timmit99/TRA_KiCad_Library/README.md

# TRA_KiCad_Library
Library of my KiCad Parts
