timmit99/TRA_KiCad_Library/3D Models/Amphenol/ssfv24r_4stlf.stp

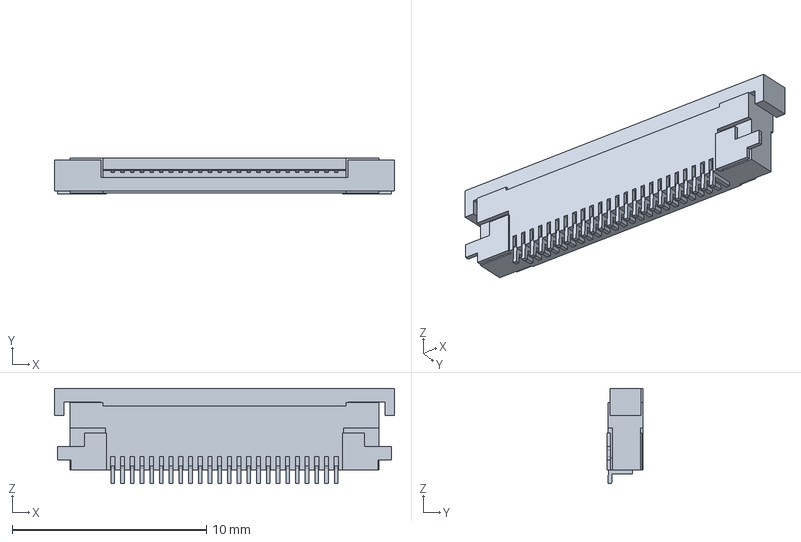
[picture p1: CAD file, 2019-06-06]
3D Models/Amphenol/ssfv24r_4stlf.stp
17.5 x 1.87 x 4.90 mm
