timmit99/TRA_KiCad_Library/3D Models/CUI Devices/SDS-60J.step

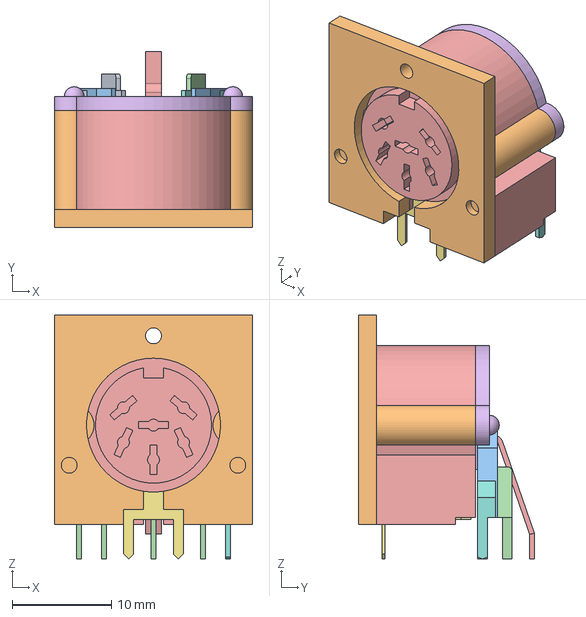
[picture p2: CAD file, 2020-04-30]
3D Models/CUI Devices/SDS-60J.step
20.0 x 17.8 x 24.6 mm
