timmit99/TRA_KiCad_Library/3D Models/en11-hsm1af15.STEP

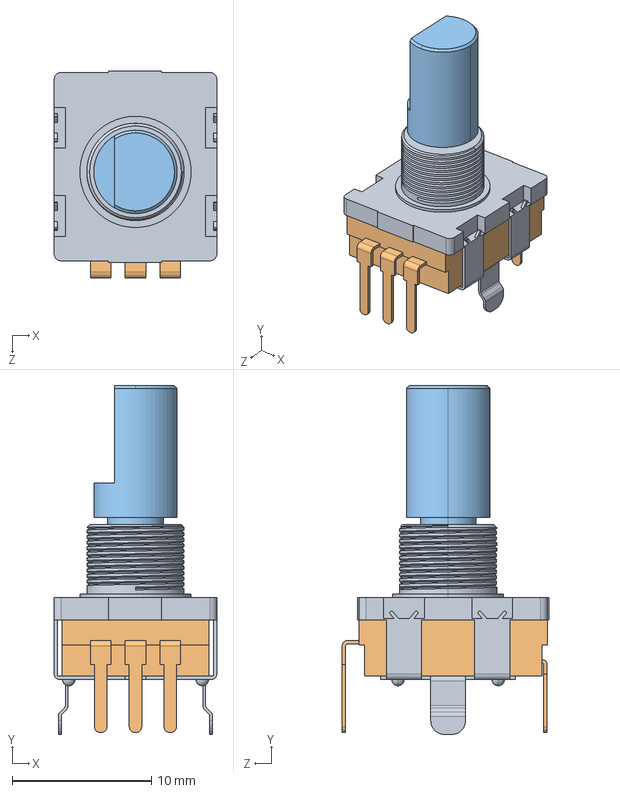
[picture p3: CAD file, 2020-04-30]
3D Models/en11-hsm1af15.STEP
11.7 x 25.1 x 14.9 mm
