timmit99/TRA_KiCad_Library/3D Models/Keystone/keystone-PN3522-2.STEP

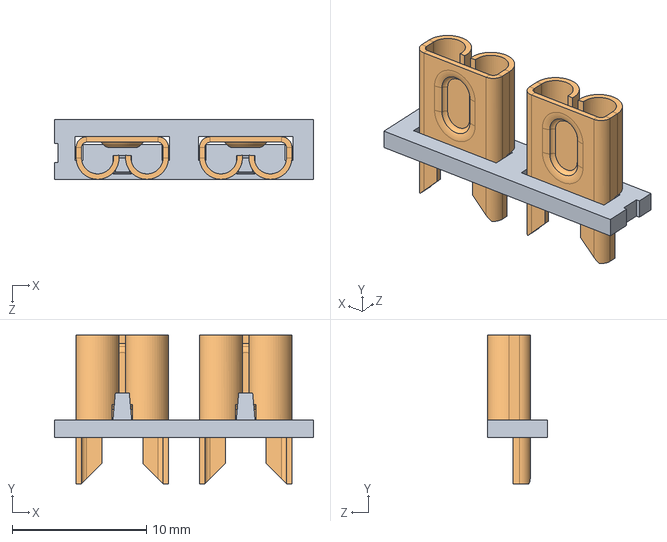
[picture p4: CAD file, 2020-01-15]
3D Models/Keystone/keystone-PN3522-2.STEP
19.3 x 11.1 x 4.44 mm
