timmit99/TRA_KiCad_Library/3D Models/Molex/Molex-70246-1001.stp

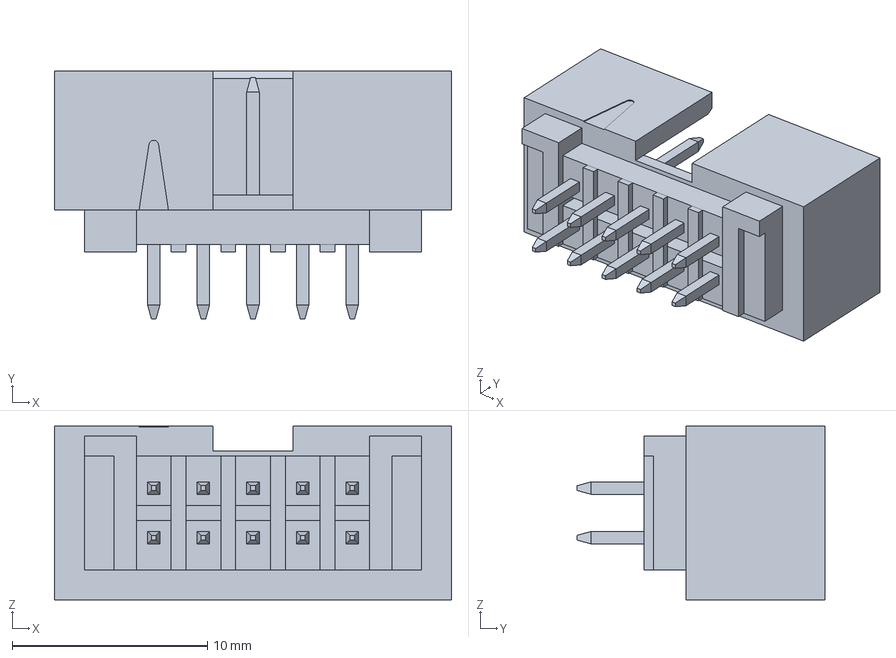
[picture p5: CAD file, 2020-01-14]
3D Models/Molex/Molex-70246-1001.stp
20.3 x 12.7 x 8.89 mm
