timmit99/TRA_KiCad_Library/3D Models/OLED Displays/I2C_1pt3in.step

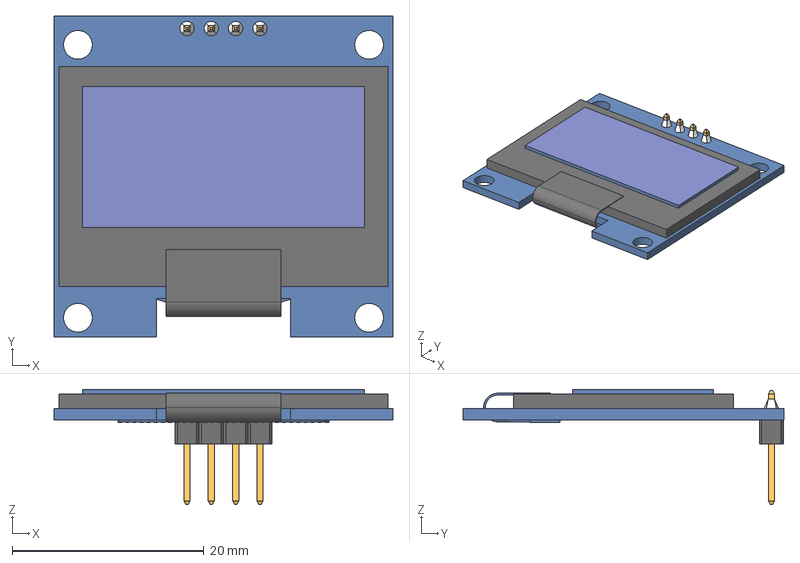
[picture p6: CAD file, 2020-04-30]
3D Models/OLED Displays/I2C_1pt3in.step
35.4 x 33.5 x 12.0 mm
Board
PIN HEADER MALE 2
LCD v2
FLEX FILM v1
4 lü Lehim v1
