timmit99/TRA_KiCad_Library/3D Models/en11-hsm1af20.step

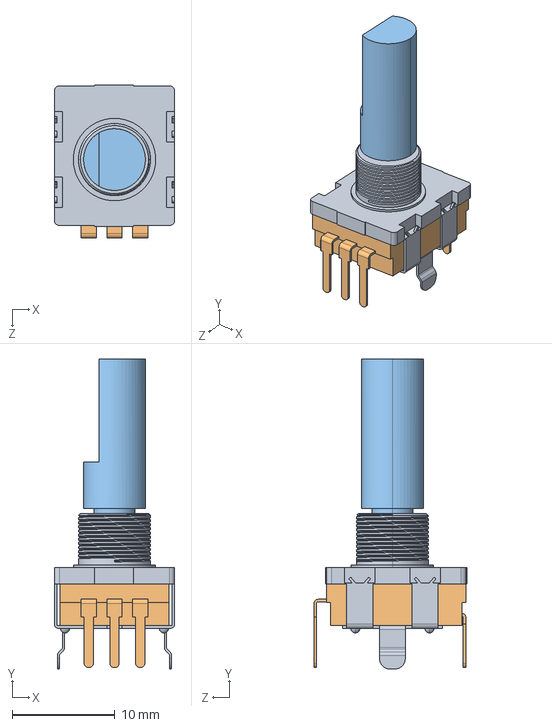
[picture p7: CAD file, 2020-04-30]
3D Models/en11-hsm1af20.step
11.7 x 30.1 x 14.9 mm
