timmit99/TRA_KiCad_Library/3D Models/Keystone/keystone-PN3544-2.STEP

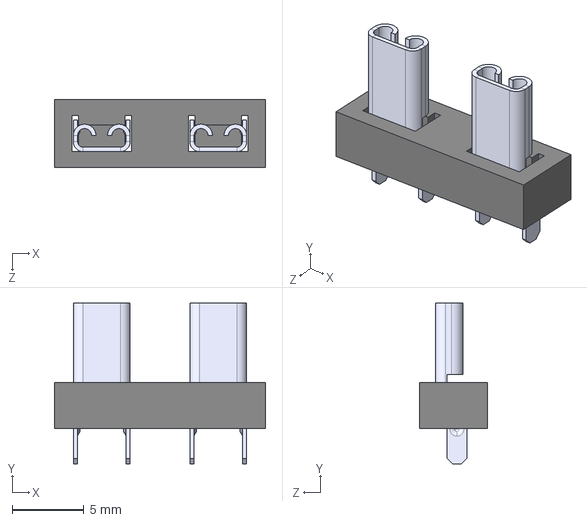
[picture p8: CAD file, 2020-01-15]
3D Models/Keystone/keystone-PN3544-2.STEP
14.7 x 11.2 x 4.75 mm
