timmit99/TRA_KiCad_Library/3D Models/Molex/Molex-545502471.stp

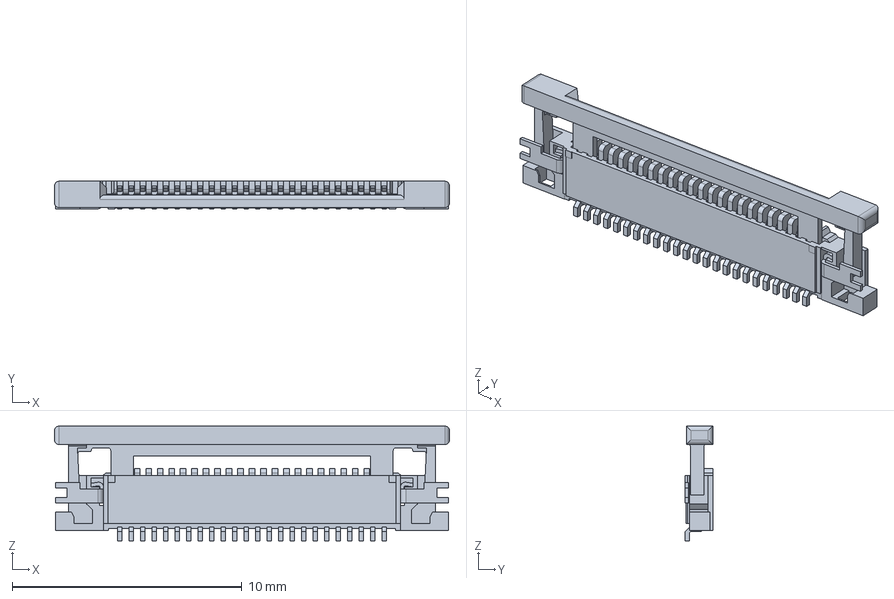
[picture p9: CAD file, 2019-06-06]
3D Models/Molex/Molex-545502471.stp
17.2 x 1.20 x 5.00 mm
