timmit99/TRA_KiCad_Library/3D Models/ESP-12F.step

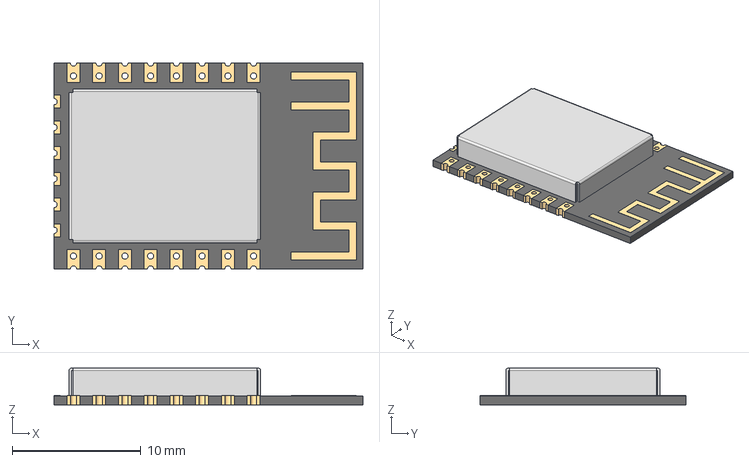
[picture p10: CAD file, 2020-01-14]
3D Models/ESP-12F.step
24.0 x 16.0 x 2.86 mm
