timmit99/TRA_KiCad_Library/3D Models/Keystone/keystone-PN3557-10.STEP

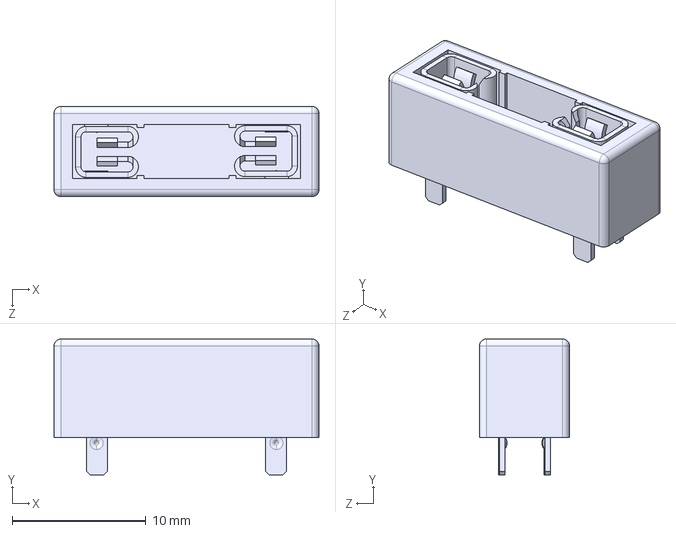
[picture p11: CAD file, 2020-01-15]
3D Models/Keystone/keystone-PN3557-10.STEP
19.8 x 10.2 x 6.73 mm
