timmit99/TRA_KiCad_Library/3D Models/Molex/Molex-70553-0003.stp

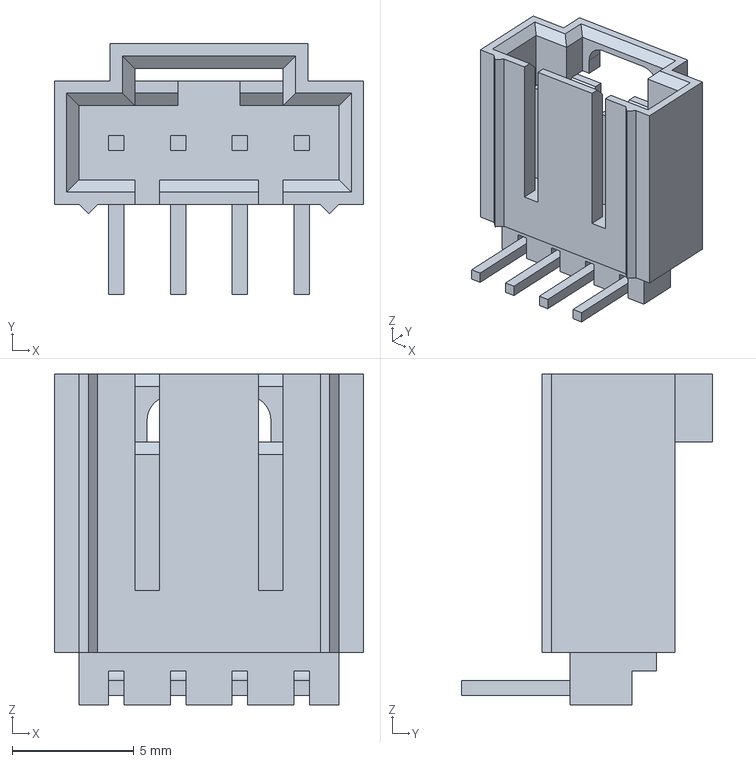
[picture p12: CAD file, 2019-05-23]
3D Models/Molex/Molex-70553-0003.stp
12.7 x 10.3 x 13.6 mm
