timmit99/TRA_KiCad_Library/3D Models/Molex/Molex-505110-2491.stp

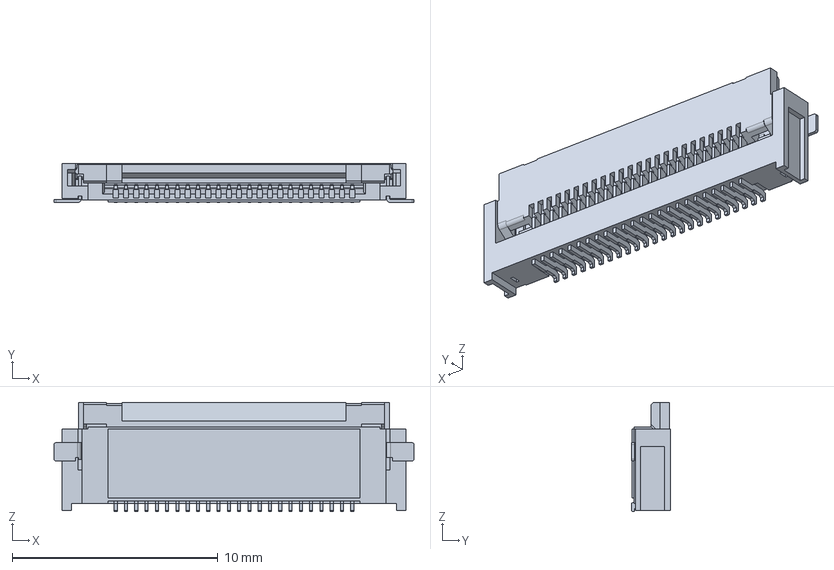
[picture p13: CAD file, 2019-03-04]
3D Models/Molex/Molex-505110-2491.stp
17.5 x 1.90 x 5.30 mm
