timmit99/TRA_KiCad_Library/3D Models/Tact Switch SMD 6x6mm.stp

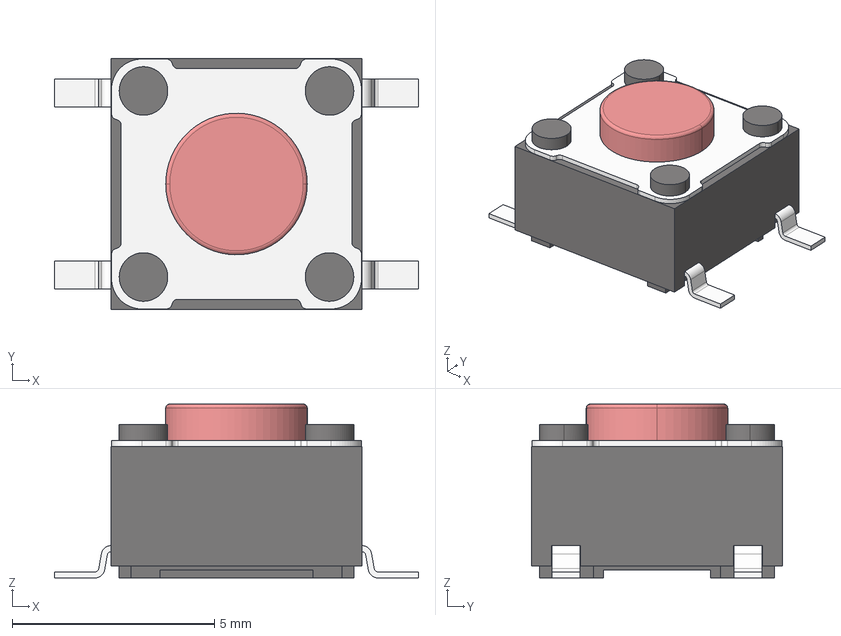
[picture p14: CAD file, 2019-06-06]
3D Models/Tact Switch SMD 6x6mm.stp
9.00 x 6.20 x 4.30 mm
