timmit99/TRA_KiCad_Library/3D Models/DO1605T-Inductor.step

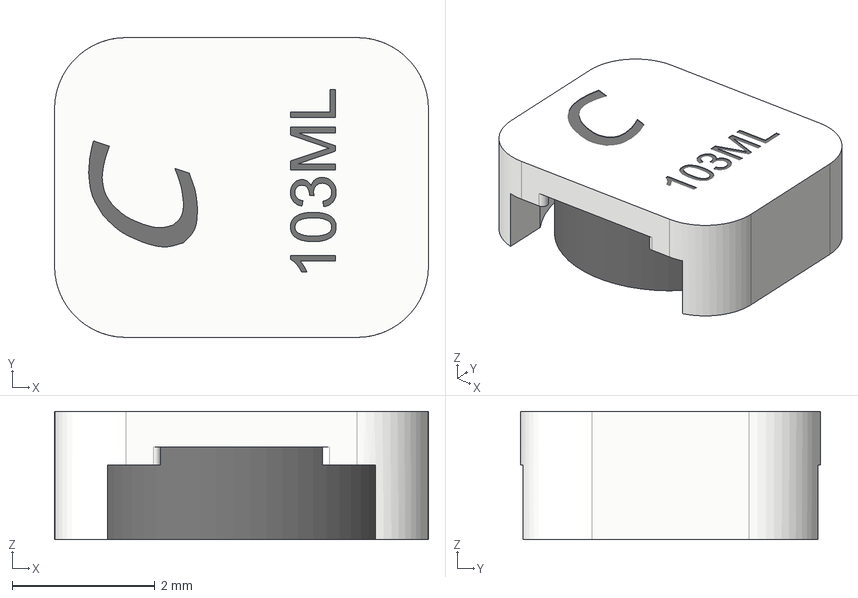
[picture p15: CAD file, 2019-06-06]
3D Models/DO1605T-Inductor.step
5.24 x 4.20 x 1.80 mm
