timmit99/TRA_KiCad_Library/3D Models/Molex/Molex-1051330001.stp

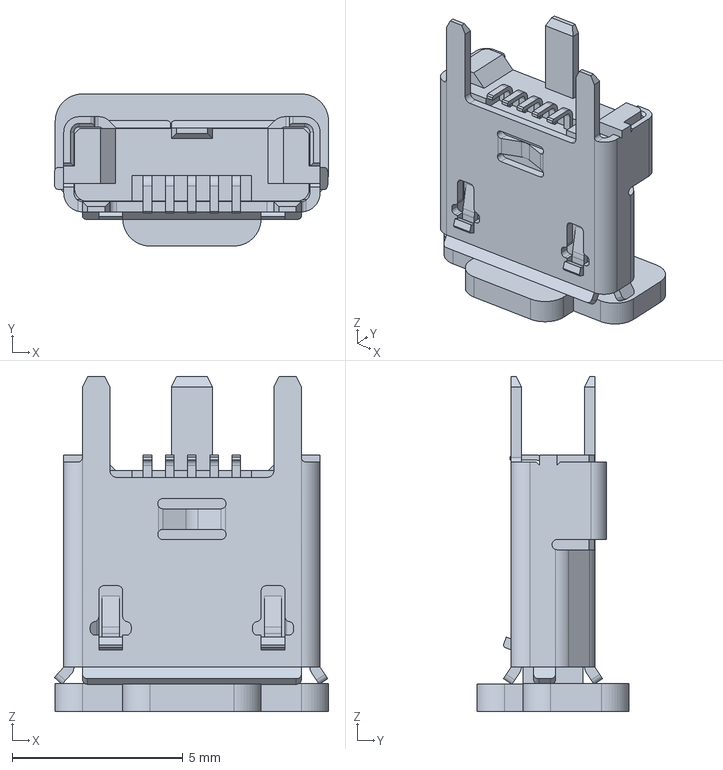
[picture p16: CAD file, 2019-03-02]
3D Models/Molex/Molex-1051330001.stp
8.03 x 4.45 x 9.80 mm
