timmit99/TRA_KiCad_Library/3D Models/Molex/Molex-1050170001.stp

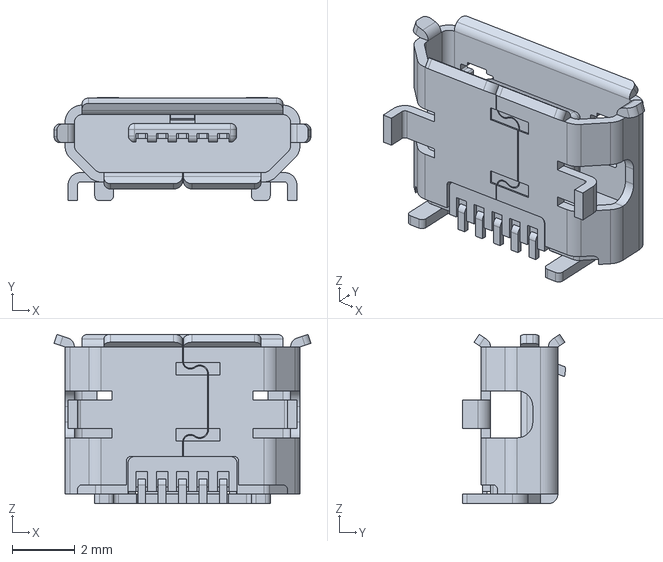
[picture p17: CAD file, 2019-03-02]
3D Models/Molex/Molex-1050170001.stp
8.20 x 3.30 x 5.40 mm
