timmit99/TRA_KiCad_Library/3D Models/WS2812_RGB_LED.stp

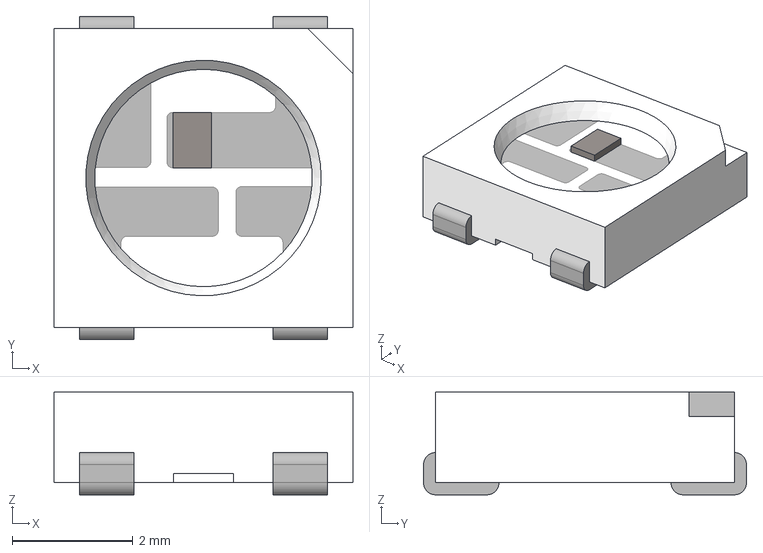
[picture p18: CAD file, 2019-05-23]
3D Models/WS2812_RGB_LED.stp
4.95 x 5.35 x 1.70 mm
