timmit99/TRA_KiCad_Library/3D Models/led5050-6.STEP

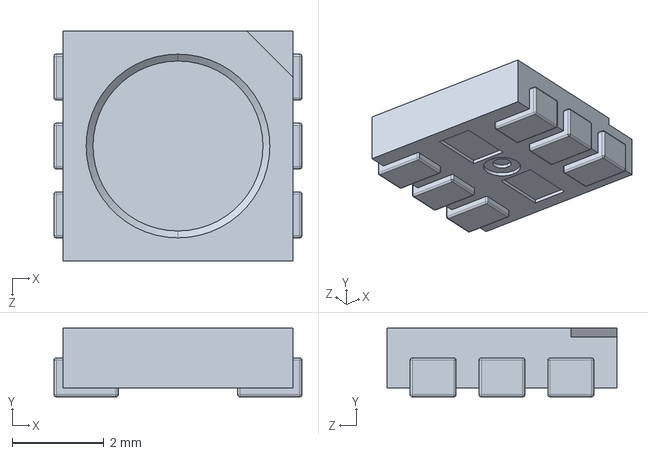
[picture p19: CAD file, 2019-05-23]
3D Models/led5050-6.STEP
5.40 x 1.50 x 5.00 mm
