timmit99/TRA_KiCad_Library/3D Models/MLF_Package.step

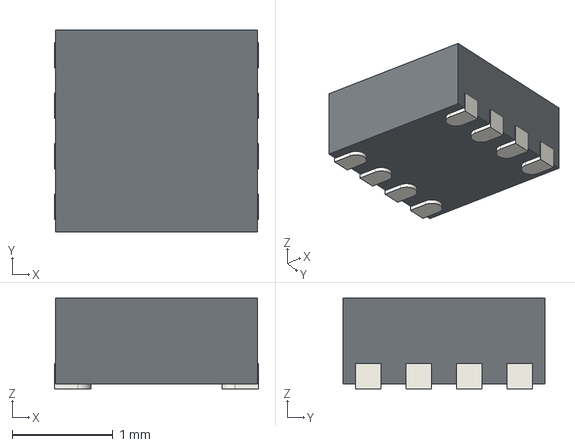
[picture p20: CAD file, 2019-03-05]
3D Models/MLF_Package.step
2.02 x 2.00 x 0.9 mm
