timmit99/TRA_KiCad_Library/3D Models/powermite.step

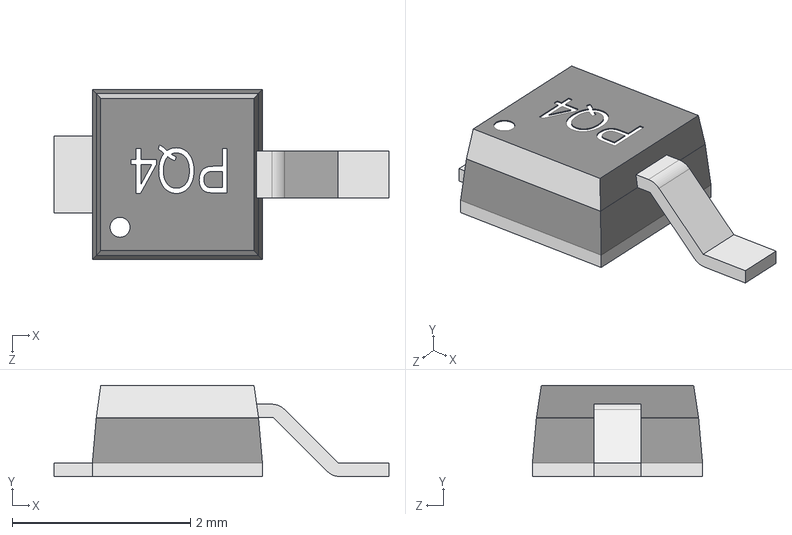
[picture p21: CAD file, 2019-03-04]
3D Models/powermite.step
3.76 x 1.02 x 1.91 mm
