timmit99/TRA_KiCad_Library/3D Models/terminal_block_blue.step

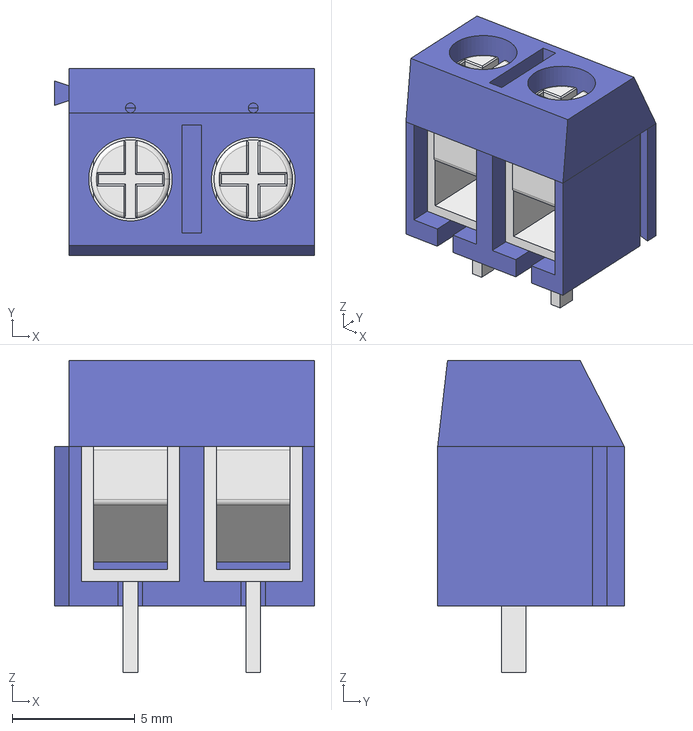
[picture p22: CAD file, 2019-03-04]
3D Models/terminal_block_blue.step
10.6 x 7.60 x 12.7 mm
