timmit99/TRA_KiCad_Library/3D Models/TL1107AFxxxWQ.stp

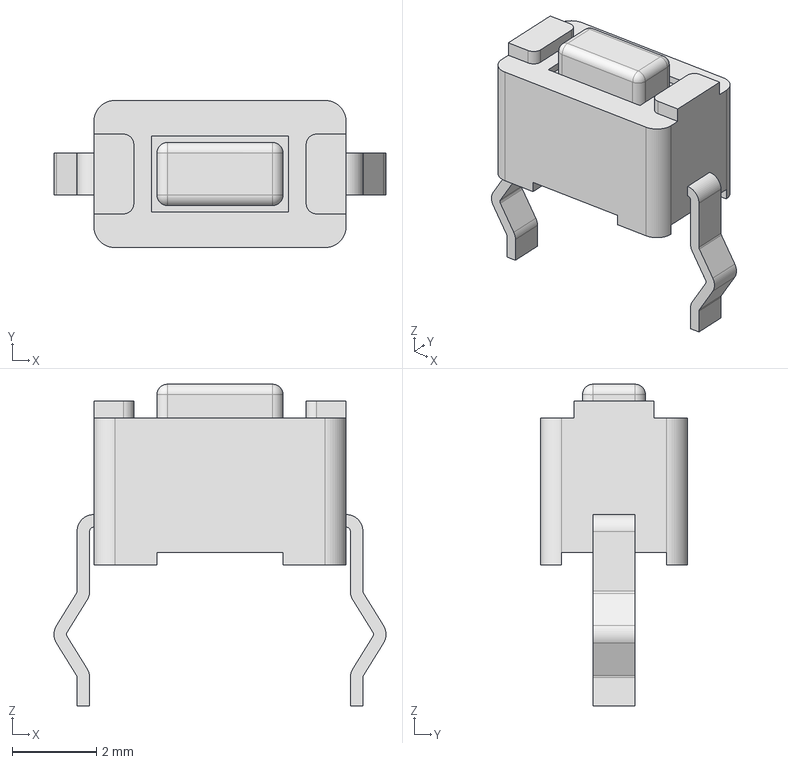
[picture p23: CAD file, 2019-03-04]
3D Models/TL1107AFxxxWQ.stp
7.90 x 3.50 x 7.65 mm
