timmit99/TRA_KiCad_Library/3D Models/02x05 1.27mmPitch Shrouded header.STEP

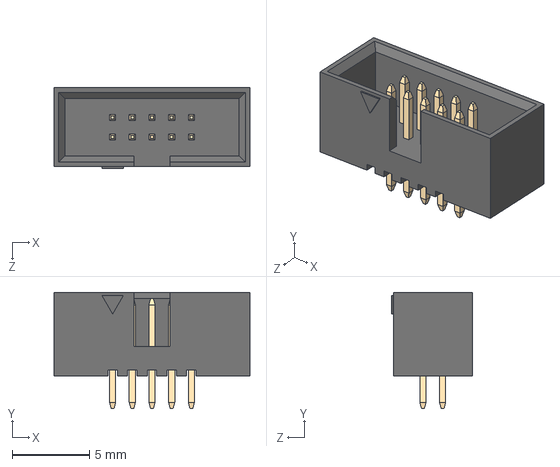
[picture p24: CAD file, 2019-03-02]
3D Models/02x05 1.27mmPitch Shrouded header.STEP
12.7 x 7.50 x 5.20 mm
