timmit99/TRA_KiCad_Library/(list of files, cad)

Other CAD files:
3D Models/Molex/Molex-1051330011.stp
3D Models/Phoenix/1715721_MKDS_2-Pin.stp
3D Models/Phoenix/1715789_MKDS_8-Pin.stp
