timmit99/TRA_KiCad_Library/(commit log)

2019-03-02 More Footprints
    Addition of Combo Vertical-Horizontal Molex USB connector as well as generic EN11 Rotory Encoder footprints
    [02x05 1.27mmPitch Shrouded header.STEP, Molex-1050170001.stp, Molex-1051330001.stp, Molex-1051330011.stp]
2019-03-02 Footprint Additions
    Adding older footprints to migrate them onto GitHub.
2019-03-02 Update SWD_Header_SMD&THT.kicad_mod
    Completing courtyard to make a soldi outline
2019-03-04 Addition of OLED components.
    Componencs for the Dial+ board inclusing a 40Pin 0.5mm pitch FFC, MIC2290 boost converter IC, and updating the SAMD21E symbol to add I2C lines.
    [Molex-505110-2491.stp, TL1107AFxxxWQ.stp, powermite.step, terminal_block_blue.step]
2019-03-05 MLF addition
    [MLF_Package.step]
2019-06-06 Footprint updats
    Aded Hall effect footprint alongside a corrected FFC connector and 2-pin button
    [DO1605T-Inductor.step, Molex-545502471.stp, Tact Switch SMD 6x6mm.stp, ssfv24r_4stlf.stp]
2020-01-14 Adding ESP modules and shrouded header
    Adding ESP 12F and 12E modules as well as a shrouded 2x5 pin header
    [ESP-12F.step, Molex-70246-1001.stp]
2020-01-15 Keystone Fuse Holders and Logos
    Additions of some Keystone Blade Fuse Holders as well as some VORON logos
    [1715721_MKDS_2-Pin.stp, 1715789_MKDS_8-Pin.stp, keystone-PN3522-2.STEP, keystone-PN3544-2.STEP, keystone-PN3557-10.STEP]
